merlinmarrs/FabVenti/syringe pump side.jpg

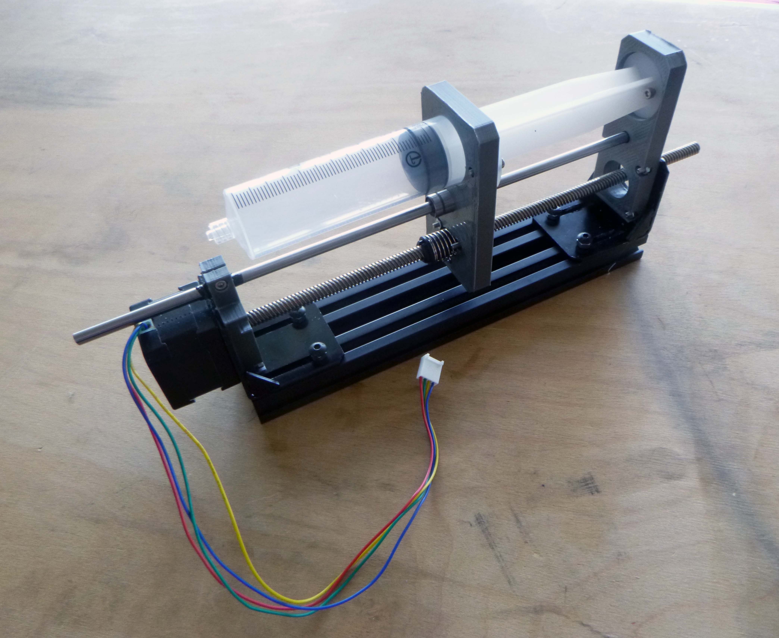
syringe pump side.jpg
