merlinmarrs/FabVenti/syringe pump elevation.jpg

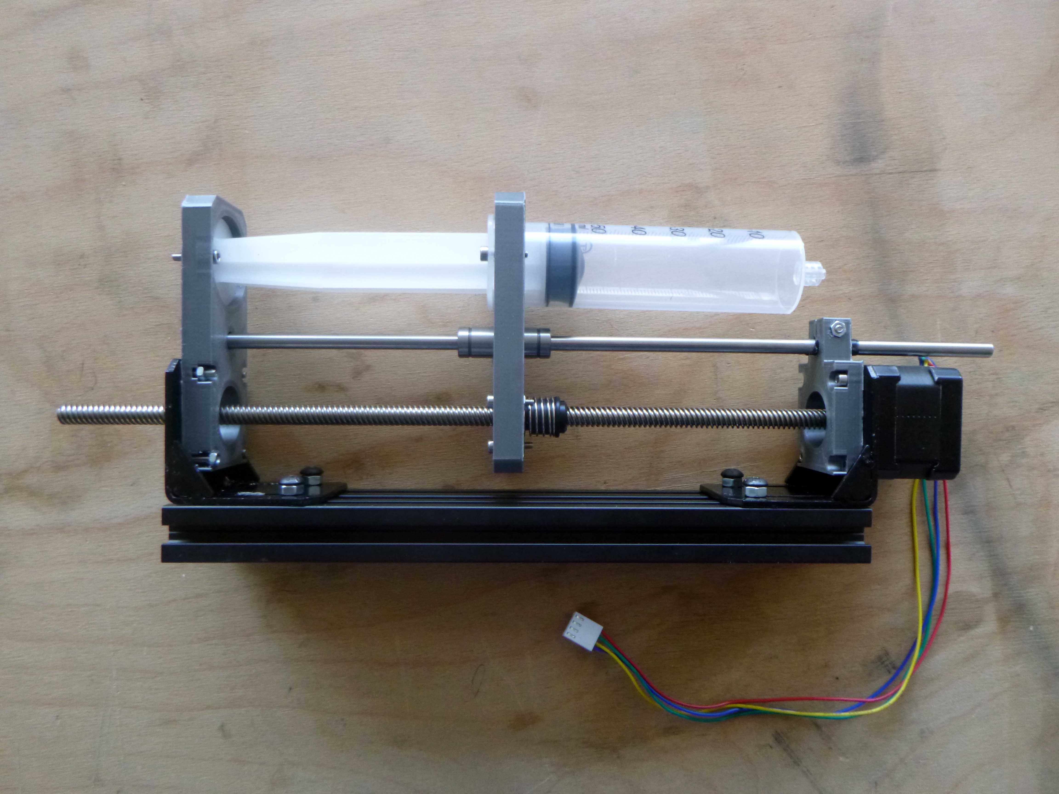
syringe pump elevation.jpg
