merlinmarrs/FabVenti/README.md

# FabVenti
Stepper Motor Driver with Atmega328p and DRV8833
Developed by Fab Lab Digiscope

See PDF for assembly instructions
