merlinmarrs/FabVenti/etapes fab venti v2.pdf

# Fab Venti Rev. 1 instructions de montage

# Avec le voltmètre aux probes fines + le microscope, vérifie que les traces adjacentes ne se touchent pas (prends au moins 5 minutes pour bien faire ça)

# vérifie que GND et VCC ne sont pas connectés

# vérifie que GND partout est relié, et que VCC partout est relié

# Pre-Soudage

# Soude ces composants pour tester le micro + le processus de télécharger le code

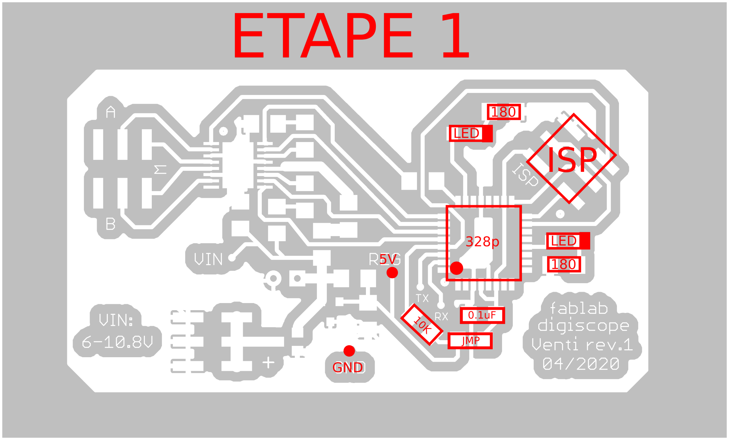
[picture p3: figure]

# Branche ISP header + alimente 5V ('REG' et

'GND'); Avec AVR Studio,

# déprogramme fusible CLKDIV=8 (on veux utiliser l'oscillateur interne de 8MHz)

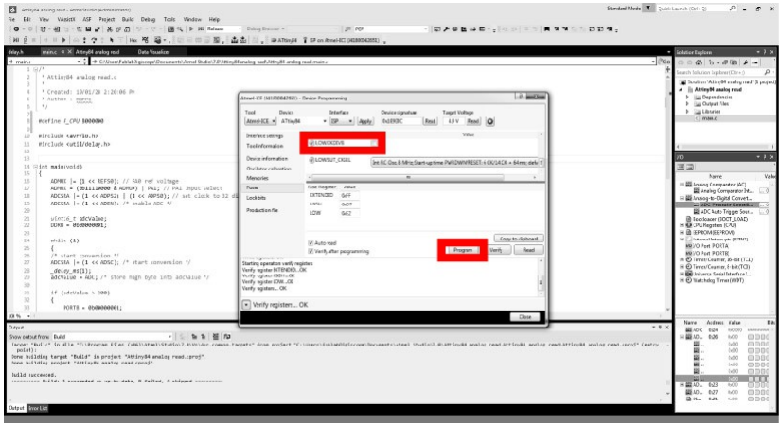
[picture p4: figure]

# Ensuite, mets le code C test dans AVR Studio

# // Fablab Digiscope // // Venti Rev.1 Blink Test Code //

// 04/2020 //

# // Target: Atmega 328P //

# #define F_CPU 8000000 // I also disable the CLKDIV8 fuse //

# #include <avr/io.h>

# #include <util/delay.h> // because I'm using _delay_ms() //

# int main(void)

{

# DDRC = 0b11111111; // All port C pins set to output DDRB = 0b11111111; // All port B pins set to output

while (1) // while value inside the brackets is non-zero, {

# PORTC = 0b11111111; // All port C pins HIGH PORTB = 0b00000000; // All port B pins LOW _delay_ms(1000); //1000ms = 1 second

# PORTC = 0b00000000; // All port C pins LOW PORTB = 0b11111111; // All port B pins HIGH

_delay_ms(1000);

}
return (0);
}

# Clique “Device Programming'

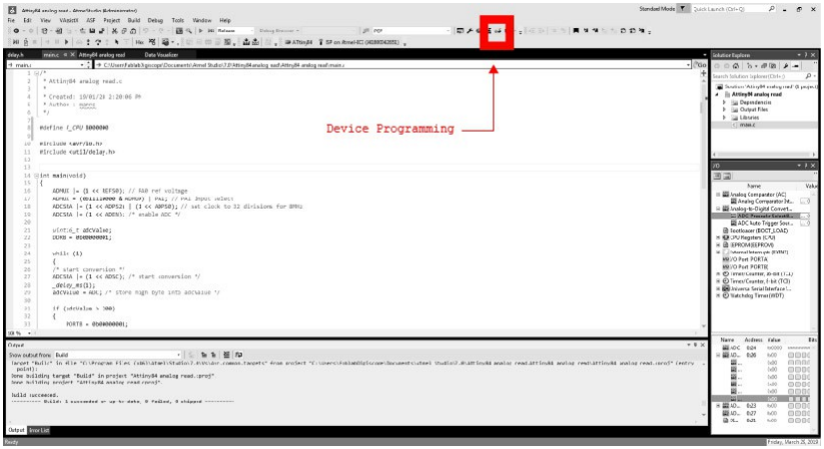
[picture p5: figure]

Selectionne Atmega 328,

# Read Voltage, ensuite programme le code C

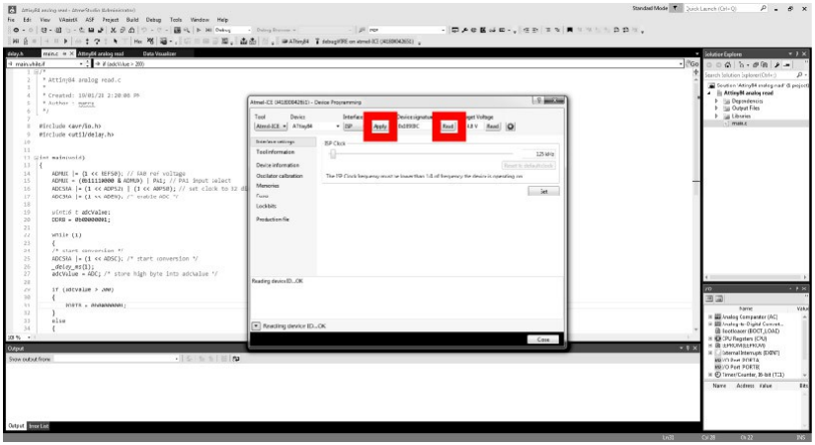
[picture p6: figure]

# Est-ce que les deux LED clignotent avec un délai d'une seconde?

# Soude les composants pour l'alimentation

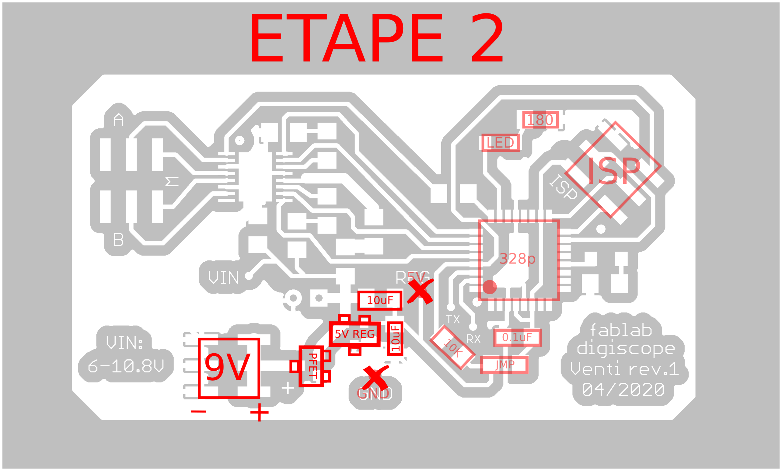
[picture p7: figure]

# Alimente avec 9V, est-ce que notre test code fonctionne comme avant?

# Est-ce que le test point 'REG' reçoit bien 5V?

# Complete le PCB

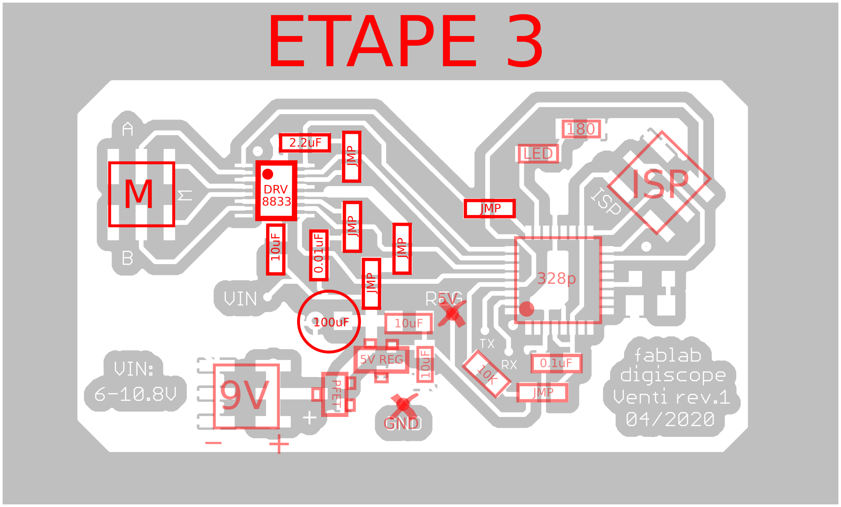
[picture p8: figure]

# Branche ISP, alimente; Programme le Venti_test.hex

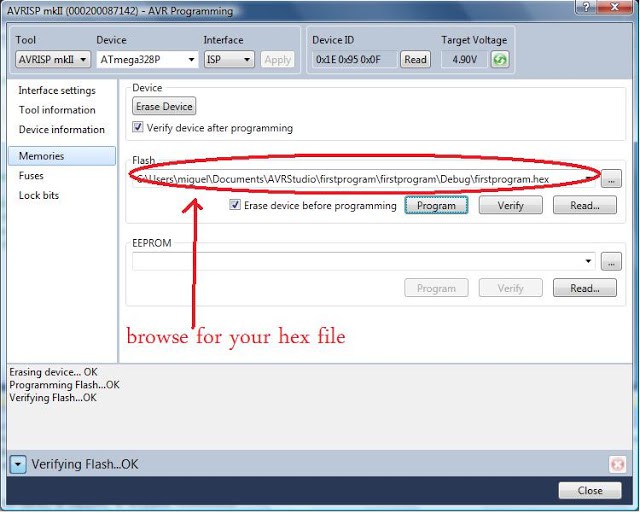
[picture p9: figure]

:100000000C9467000C9484000C9484000C9484007D :100010000C9484000C9484000C9484000C94840050 :100020000C9484000C9484000C9484000C94840040 :100030000C9484000C9484000C9484000C94840030 :100040000C94AE020C9484000C9484000C948400F4 :100050000C9484000C9484000C9484000C94840010 :100060000C9484000C948400710178018401950142 :1000700097019E01AA01BB01D101D3010000000834 :10008000000201000003040700000000000000005F :1000900000000000250028002B00000000002400C4 :1000A00027002A00040404040404040402020202D7 :1000B000020203030303030301020408102040802B :1000C0000102040810200102040810207E031124FC :1000D0001FBECFEFD8E0DEBFCDBF21E0A0E0B1E092 :1000E00001C01D92A332B207E1F710E0C7E6D0E0ED :1000F00004C02197FE010E94E603C636D107C9F766 :100100000E94F8020C9422040C94000090E0FC0180 :10011000E854FF4F2491FC01EC55FF4F8491882354 :1001200099F090E0880F991FFC01E656FF4FA591CA :10013000B491FC01E057FF4F859194918FB7F894EB :10014000EC91E22BEC938FBF089590E0FC01E45812 :10015000FF4F3491FC01E854FF4F2491FC01EC5512 :10016000FF4FE491EE2309F43BC0332339F13330E0 :1001700091F038F43130A9F0323001F584B58F7D3B :1001800012C0373091F03830A1F03430B9F480919A :1001900080008F7D03C0809180008F7780938000E6 :1001A0000DC084B58F7784BD09C08091B0008F7772 :1001B00003C08091B0008F7D8093B000F0E0EE0F1F :1001C000FF1FE057FF4FA591B4918FB7F894EC91C2 :1001D000611103C020952E2301C02E2B2C938FBFBD :1001E0000895CF93DF93EC0180911101909112015A :1001F000029709F5C130D10569F024F42097D9F4AC :1002000060E009C0C230D10561F0C330D10599F476 :1002100060E008C061E0809115010E94A50061E0E6 :100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
:00000001FF

# Branche le moteur à pas (un pair > A, l'autre pair > B); Alimente avec 9V; est-ce que ça tourne dans une direction et ensuite dans l'autre (et est-ce que les LED suivent?)

# Avec un ohmètre, trouve les deux pairs de fils du moteur à pas (les fils d'un pair auront à peu pres la meme résistance)

# BRAVO!!
