merlinmarrs/FabVenti/3d model of extruder.jpg

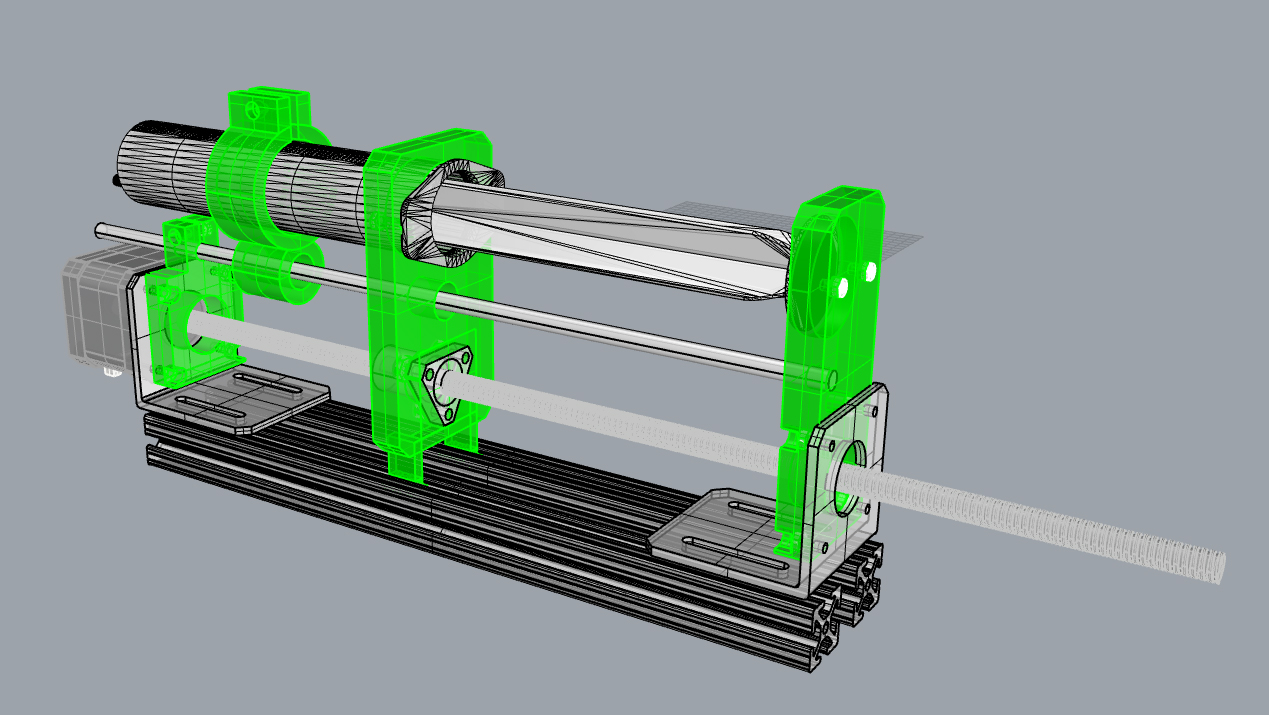
3d model of extruder.jpg
