merlinmarrs/FabVenti/fab venti.jpg

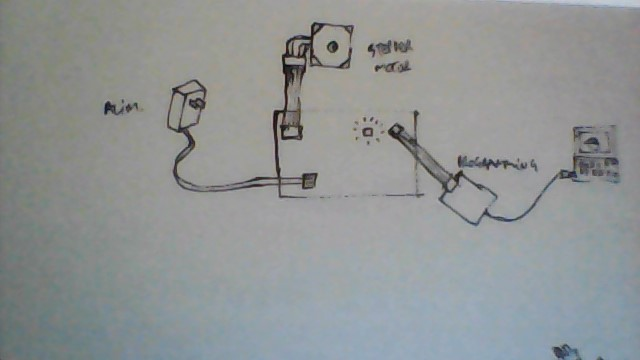
fab venti.jpg
