merlinmarrs/FabVenti/rev1 final.png

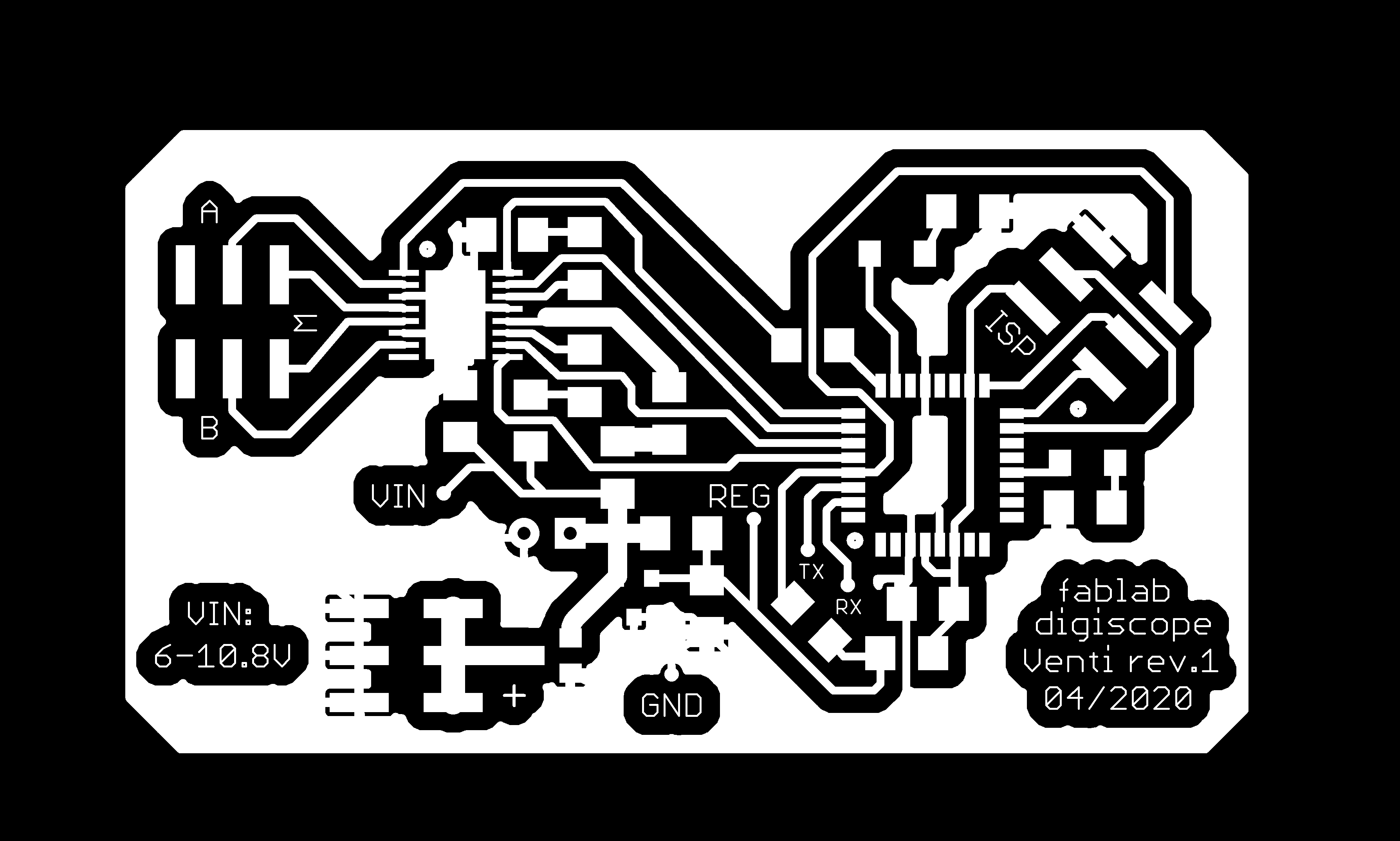
rev1 final.png
