merlinmarrs/FabVenti/part 3.stl

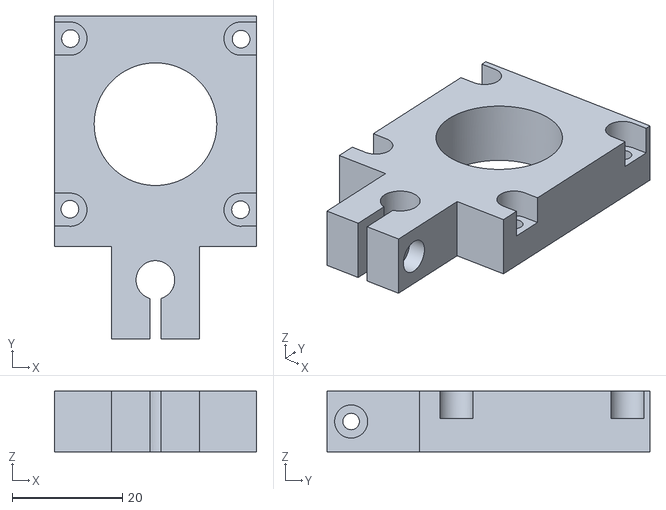
[picture p13: CAD file, 2020-05-14]
part 3.stl
36.6 x 58.5 x 11.0
