merlinmarrs/FabVenti/part 2.stl

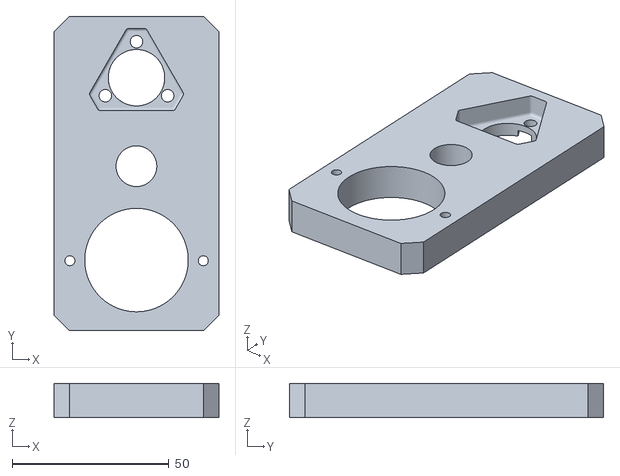
[picture p14: CAD file, 2020-05-14]
part 2.stl
52.6 x 100.3 x 11.0
