merlinmarrs/FabVenti/part 1.stl

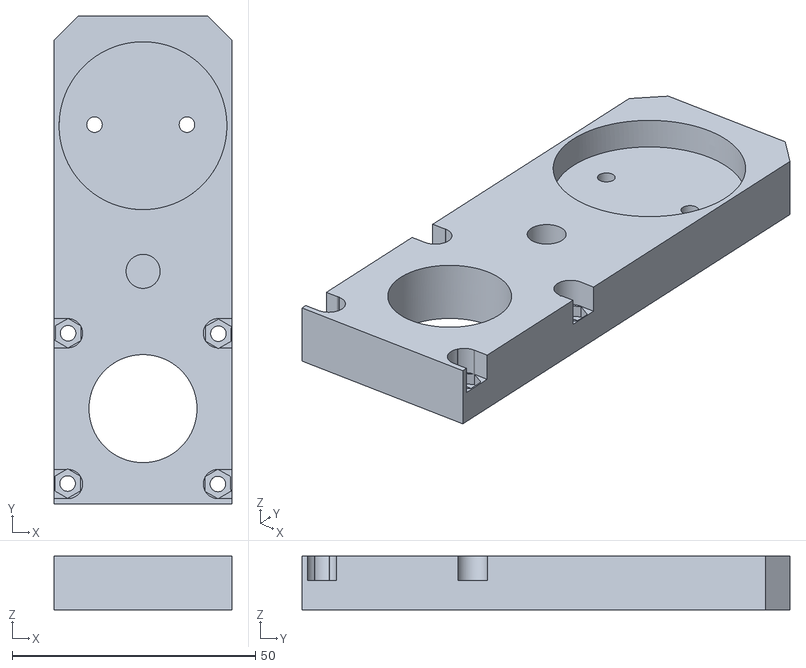
[picture p15: CAD file, 2020-05-14]
part 1.stl
36.6 x 100.3 x 11.0
