merlinmarrs/FabVenti/part 5.stl

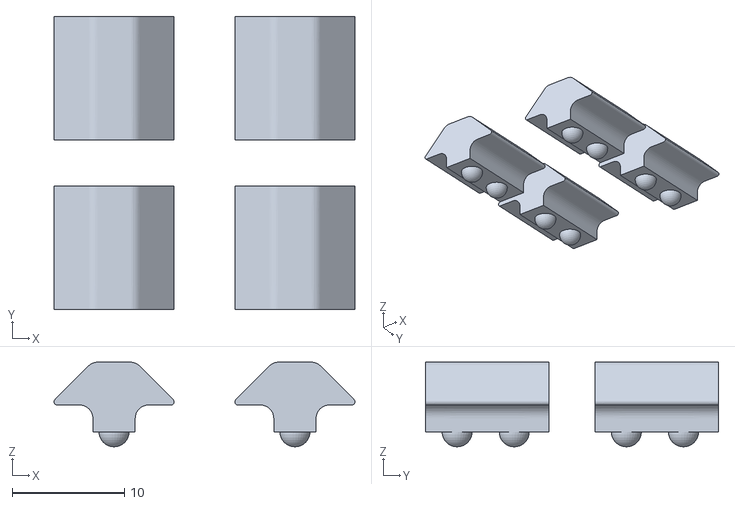
[picture p16: CAD file, 2020-05-14]
part 5.stl
26.8 x 26.1 x 7.55
