merlinmarrs/FabVenti/part 4.stl

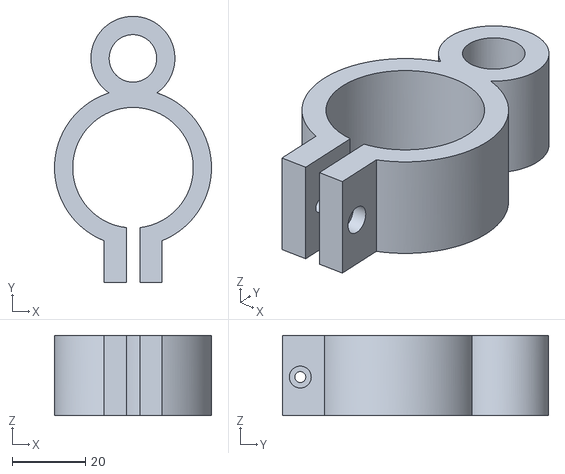
[picture p17: CAD file, 2020-05-14]
part 4.stl
43.0 x 72.9 x 22.0
