merlinmarrs/FabVenti/Venti rev1.brd

## EAGLE design Venti rev1.brd (2020-04-20)

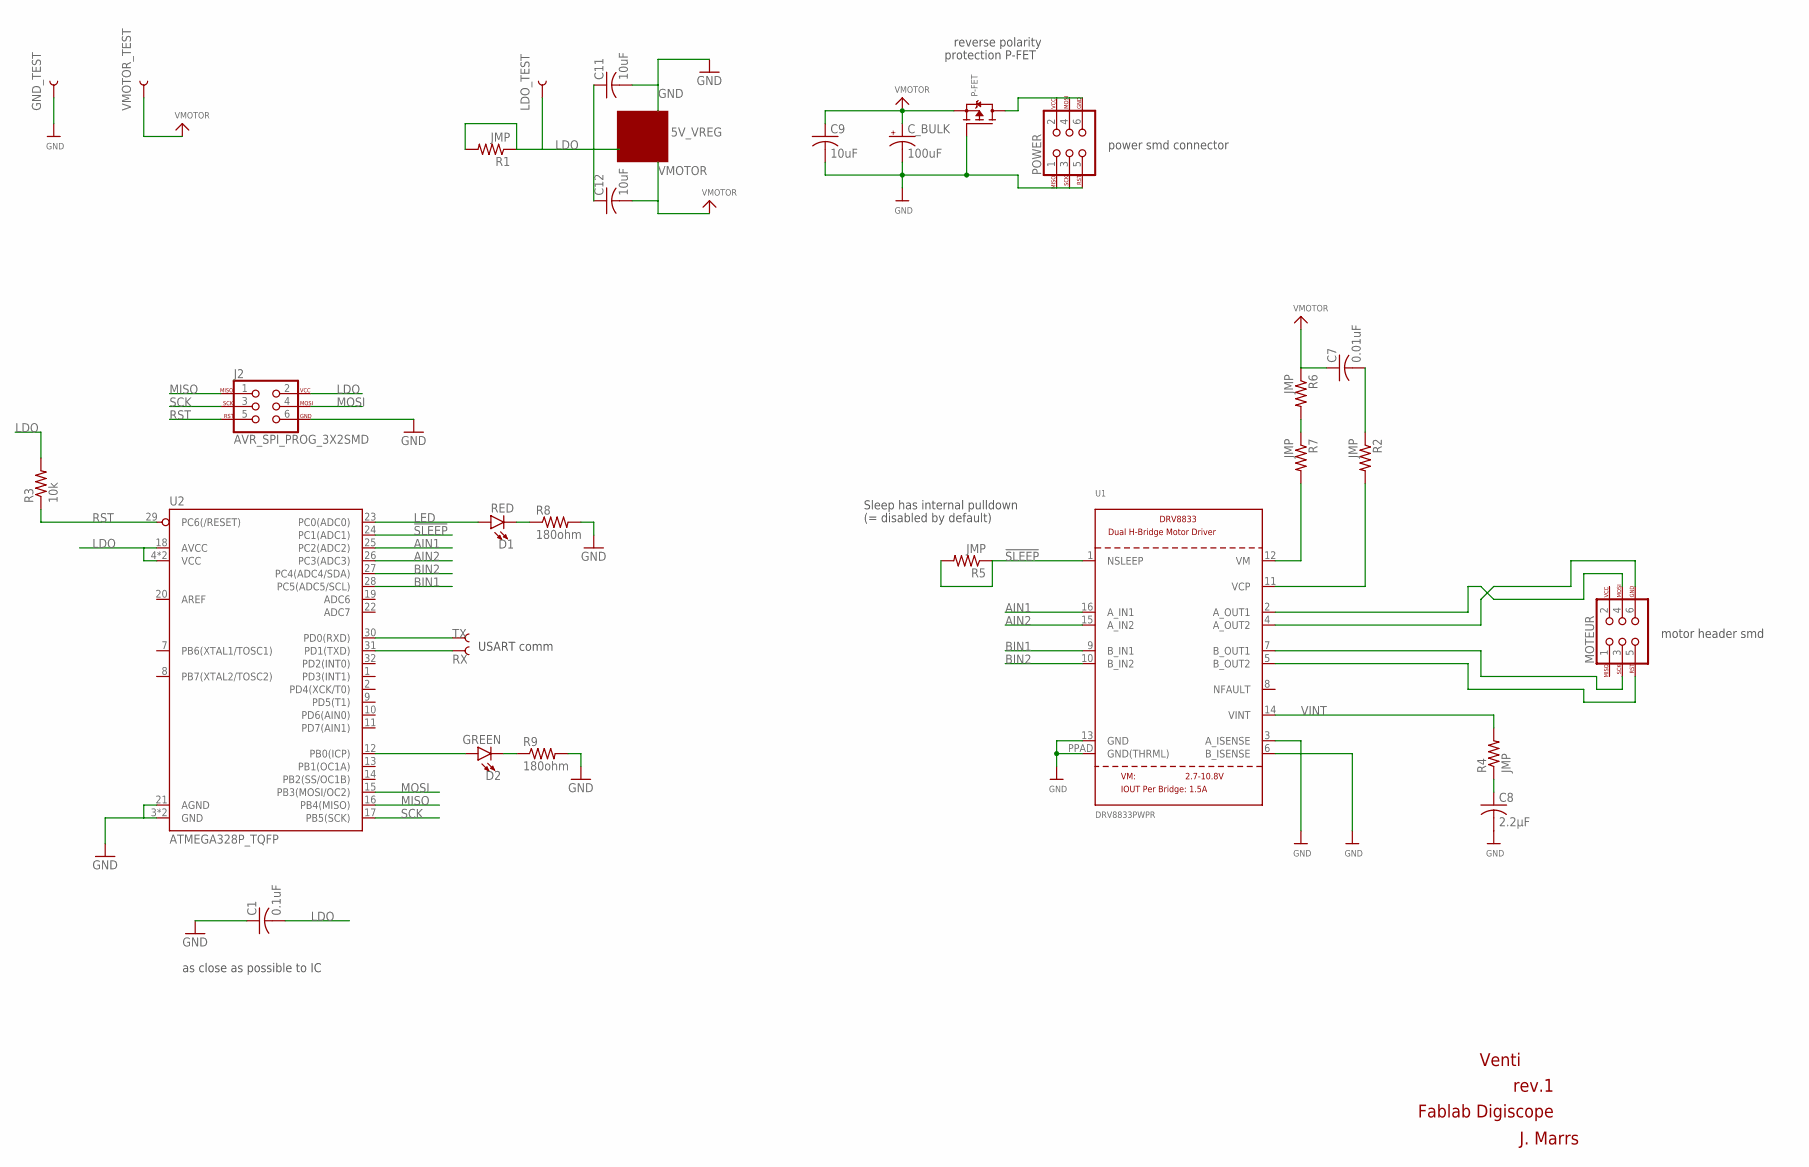
[picture p18: schematic Venti rev1.sch]

Parts:
5V_VREG: MOSFET_PCH-DMG2305UX-7; SOT23-3
C1: 0.1uF; C1206
C7: 0.01uF; C1206
C8: 2.2μF; C1206
C9, C11, C12: 10uF; C1206
C_BULK: 100uF; CPOL-RADIAL-2.5MM-6.5MM
D1: RED; LED-1206
D2: GREEN; LED-1206
GND_TEST: TEST-POINT3; PAD.03X.03
J2: AVR_SPI_PROG_3X2SMD; 2X3_SMT_POSTS
LDO_TEST: TEST-POINT3; PAD.03X.03
MOTEUR: AVR_SPI_PROG_3X2SMD; 2X3_SMT_POSTS
P-FET: MOSFET-PWIDE; SOT23-WIDE
POWER: AVR_SPI_PROG_3X2SMD; 2X3_SMT_POSTS
R1, R2, R4, R5, R6, R7: JMP; R1206
R3: 10k; R1206
R8, R9: 180ohm; R1206
RX: TEST-POINT3; PAD.03X.03
TX: TEST-POINT3; PAD.03X.03
U1: DRV8833PWPR; HTSSOP16
U2: ATMEGA328P_TQFP; TQFP32-08
VMOTOR_TEST: TEST-POINT3; PAD.03X.03

Connections:
!SLEEP: R5.1, R5.2, U1.1 (NSLEEP), U2.24 (PC1(ADC1))
AIN1: U1.16 (A_IN1), U2.25 (PC2(ADC2))
AIN2: U1.15 (A_IN2), U2.26 (PC3(ADC3))
AOUT1: MOTEUR.4, U1.2 (A_OUT1)
AOUT2: MOTEUR.6, U1.4 (A_OUT2)
BIN1: U1.9 (B_IN1), U2.28 (PC5(ADC5/SCL))
BIN2: U1.10 (B_IN2), U2.27 (PC4(ADC4/SDA))
BOUT1: MOTEUR.3, U1.7 (B_OUT1)
BOUT2: MOTEUR.5, U1.5 (B_OUT2)
GND: 5V_VREG.3 (D), C1.1, C8.2, C9.2, C11.2, C_BULK.2 (-), GND_TEST.P$1, J2.6, P-FET.1 (G), POWER.1, POWER.3, POWER.5, R8.2, R9.2, U1.3 (A_ISENSE), U1.6 (B_ISENSE), U1.13 (GND), U1.PPAD (GND(THRML)), U2.3 (GND), U2.5 (GND), U2.21 (AGND)
LDO: 5V_VREG.1 (G), C1.2, C11.1, C12.1, J2.2, LDO_TEST.P$1, R1.1, R1.2, R3.2, U2.4 (VCC), U2.6 (VCC), U2.18 (AVCC)
LED: D1.A, U2.23 (PC0(ADC0))
MISO: J2.1, U2.16 (PB4(MISO))
MOSI: J2.4, U2.15 (PB3(MOSI/OC2))
unnamed: C8.1, R4.1
unnamed: C7.2, R2.1
unnamed: R7.2, U1.12 (VM)
unnamed: R6.2, R7.1
unnamed: TX.P$1, U2.30 (PD0(RXD))
unnamed: RX.P$1, U2.31 (PD1(TXD))
unnamed: R2.2, U1.11 (VCP)
unnamed: D2.A, U2.12 (PB0(ICP))
unnamed: D1.C, R8.1
unnamed: D2.C, R9.1
PWRIN: P-FET.3 (D), POWER.2, POWER.4, POWER.6
RST: J2.5, R3.1, U2.29 (PC6(/RESET))
SCK: J2.3, U2.17 (PB5(SCK))
VINT: R4.2, U1.14 (VINT)
VMOTOR: 5V_VREG.2 (S), C7.1, C9.1, C12.2, C_BULK.1 (+), P-FET.2 (S), R6.1, VMOTOR_TEST.P$1

Notes on the sheet:
Sleep has internal pulldown
(= disabled by default)
motor header smd
power smd connector
Venti
rev.1
Fablab Digiscope
J. Marrs
USART comm
as close as possible to IC
reverse polarity
protection P-FET

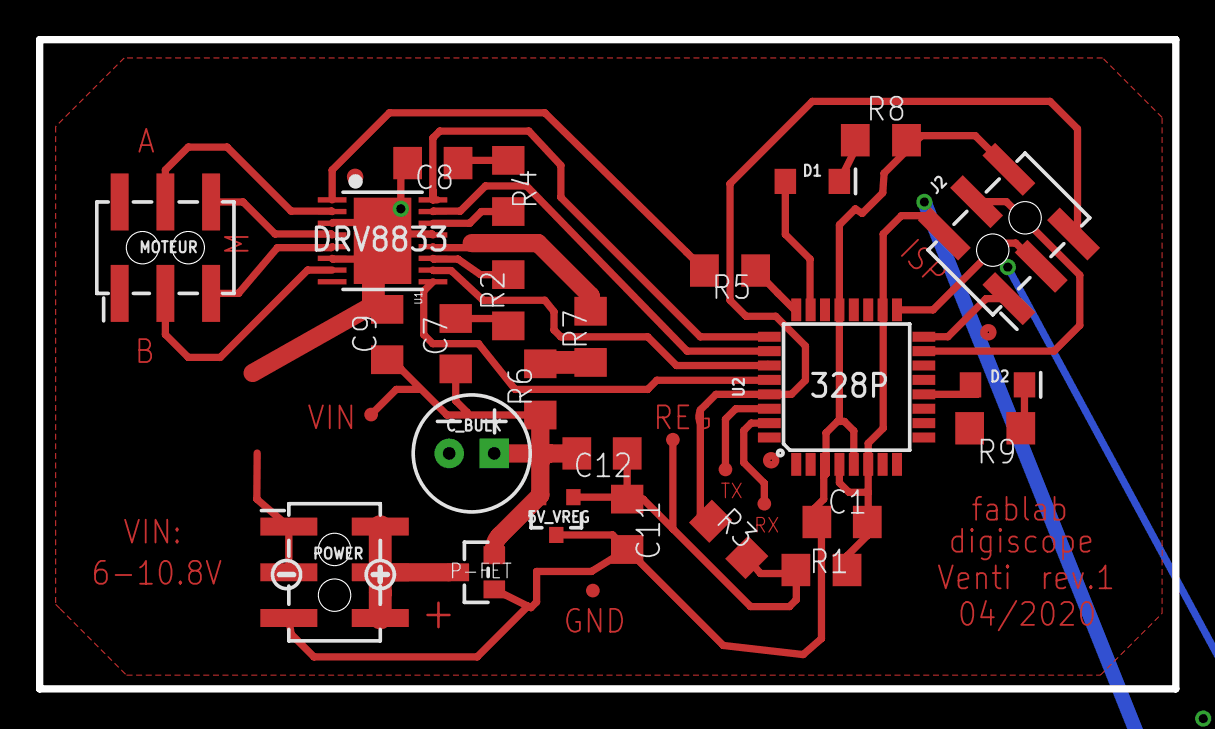
[picture p19: board Venti rev1.brd from above]

Board: 2 copper layers, 63.1 x 36.1 mm, 33 parts (1 on the bottom side), 29 nets.

Other parts of the board:
U$15: SYMBOL_PLUS
U$16: SYMBOL_MINUS
U$17: ADAFRUIT_3.5MM
